Roch22/Dolphin-Floater/releases/v4/tube v3 vs v4.png

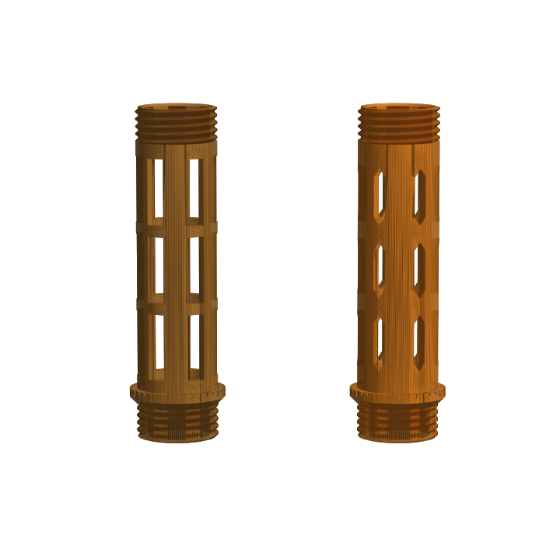
releases/v4/tube v3 vs v4.png
