Roch22/Dolphin-Floater/releases/v1 test pack/Dolphin Floater v1 TEST PACK.3mf

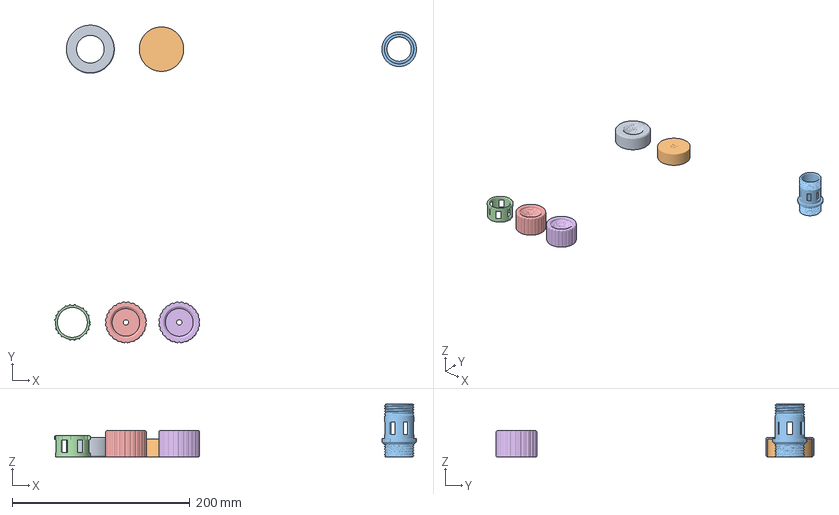
[picture p2: CAD file, 2026-10-24]
releases/v1 test pack/Dolphin Floater v1 TEST PACK.3mf
407.0 x 357.2 x 59.5 mm
socket_test
leak_test_puck
tube_test
sleeve_test
cap_0.25
cap_0.35
