Roch22/Dolphin-Floater/releases/v1 test pack/STL/sleeve_test.stl

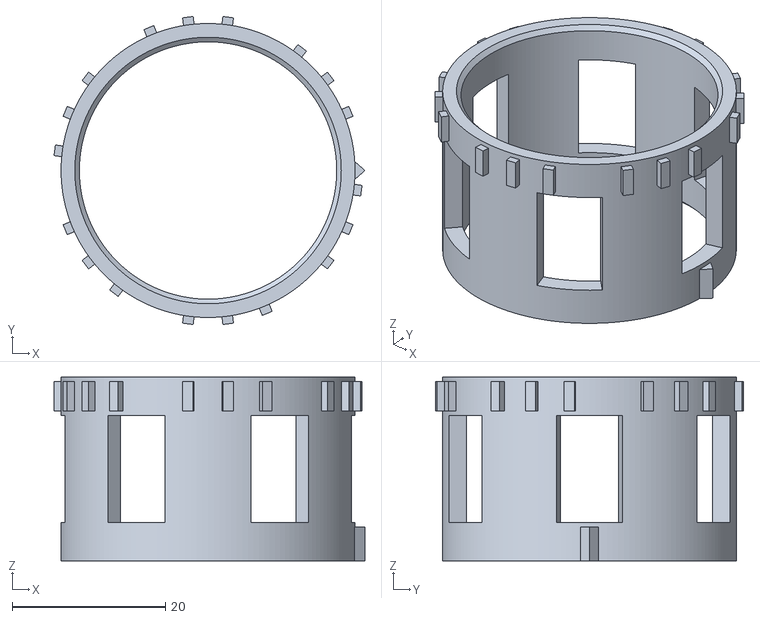
[picture p3: CAD file, 2026-10-24]
releases/v1 test pack/STL/sleeve_test.stl
40.6 x 40.2 x 24.0
