Roch22/Dolphin-Floater/releases/v4/Tube v4 test.3mf

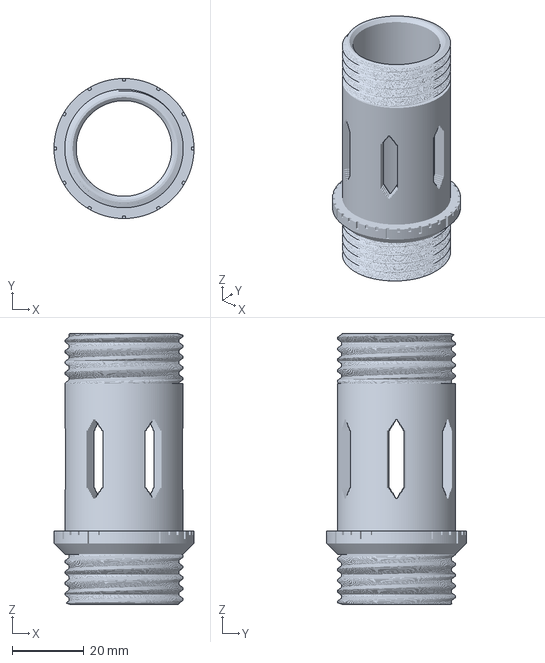
[picture p4: CAD file, 2026-10-29]
releases/v4/Tube v4 test.3mf
39.0 x 39.0 x 75.5 mm
