Roch22/Dolphin-Floater/releases/v1 test pack/STL/socket_test.stl

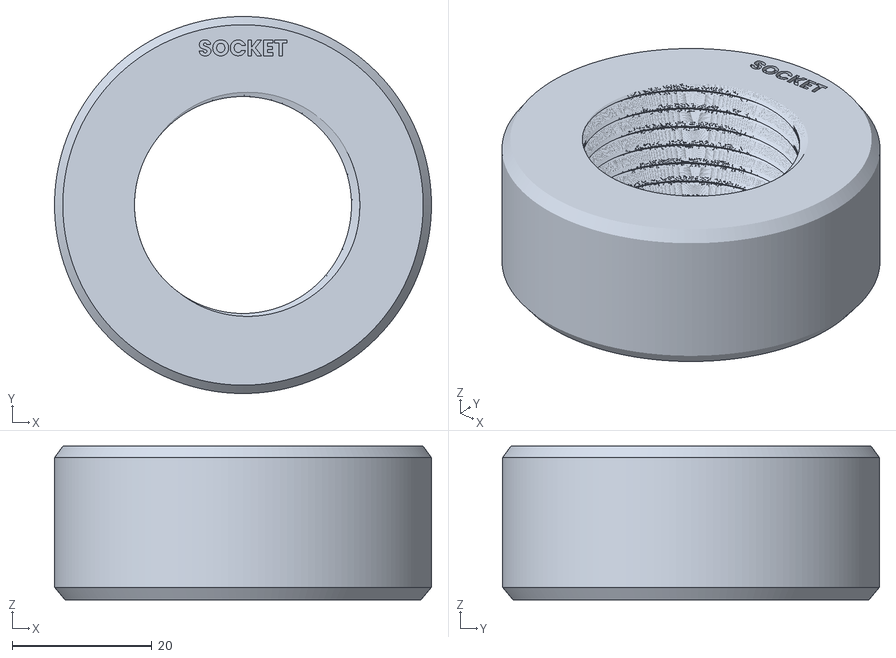
[picture p5: CAD file, 2026-10-24]
releases/v1 test pack/STL/socket_test.stl
54.0 x 54.0 x 22.0
