Roch22/Dolphin-Floater/releases/v4/Dolphin Floater v4.3mf

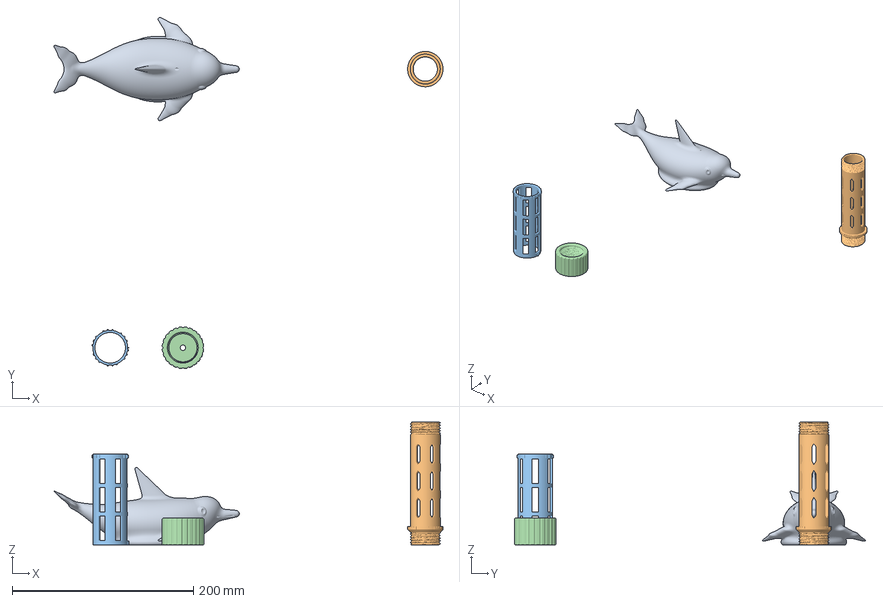
[picture p6: CAD file, 2026-10-29]
releases/v4/Dolphin Floater v4.3mf
428.8 x 387.1 x 135.5 mm
dolphin_float
tube_v4
sleeve
cap_washer_pause
