Roch22/Dolphin-Floater/releases/v1 test pack/STL/leak_test_puck.stl

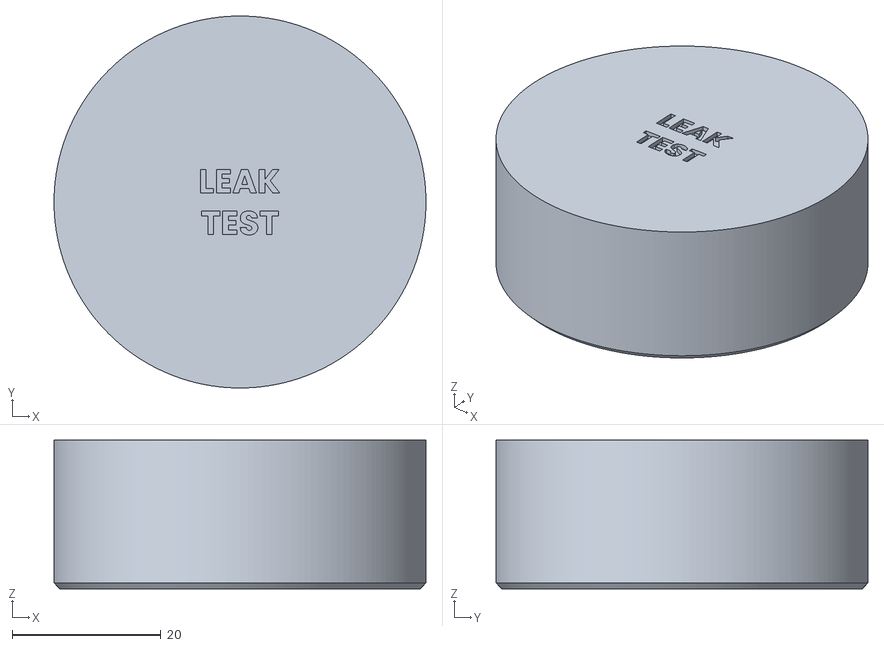
[picture p7: CAD file, 2026-10-24]
releases/v1 test pack/STL/leak_test_puck.stl
50.0 x 50.0 x 20.0
