Roch22/Dolphin-Floater/releases/v1 test pack/STL/tube_test.stl

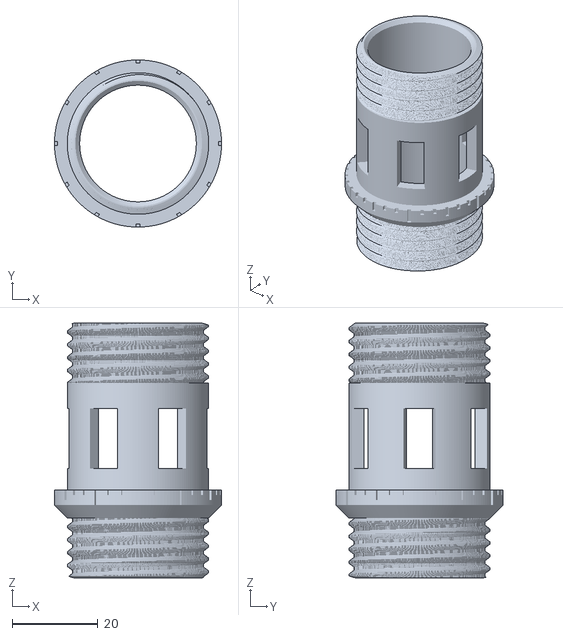
[picture p8: CAD file, 2026-10-24]
releases/v1 test pack/STL/tube_test.stl
39.0 x 39.0 x 59.5
