Roch22/Dolphin-Floater/releases/v1 test pack/STL/cap_0.35.stl

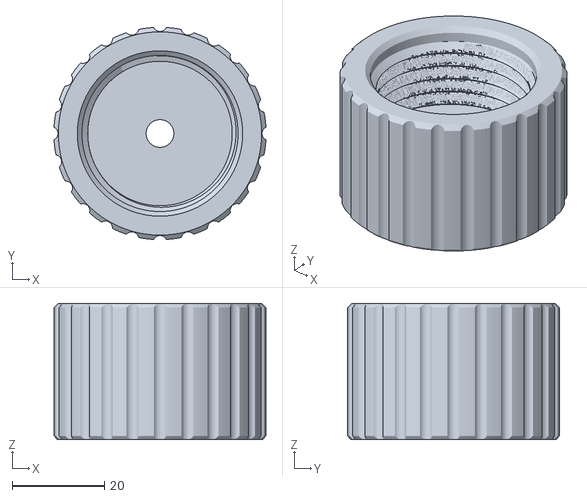
[picture p9: CAD file, 2026-10-24]
releases/v1 test pack/STL/cap_0.35.stl
45.9 x 45.9 x 29.5
