Roch22/Dolphin-Floater/releases/v3/Dolphin Floater v3.3mf

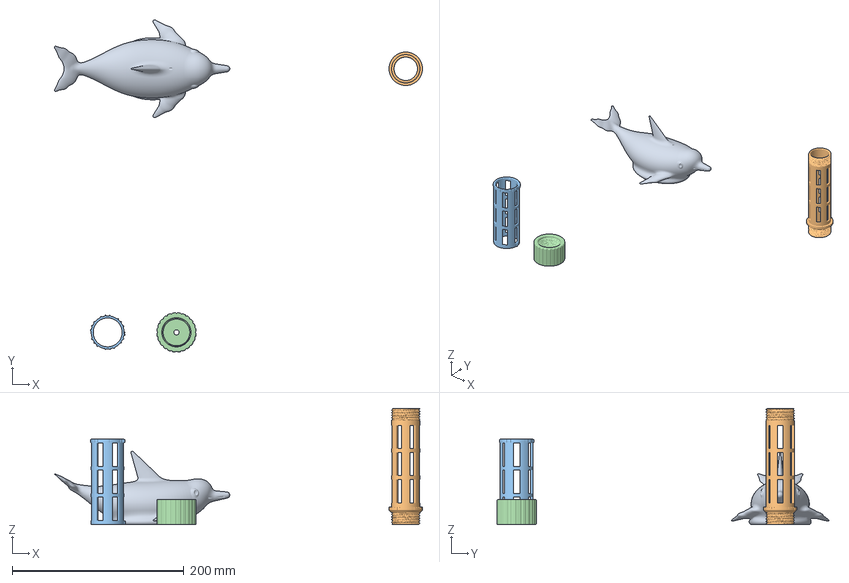
[picture p10: CAD file, 2026-10-24, an earlier design]
releases/v3/Dolphin Floater v3.3mf
428.8 x 387.1 x 135.5 mm
dolphin_float
tube
sleeve
cap_washer_pause
