Roch22/Dolphin-Floater/releases/v3/STL/dolphin_float.stl

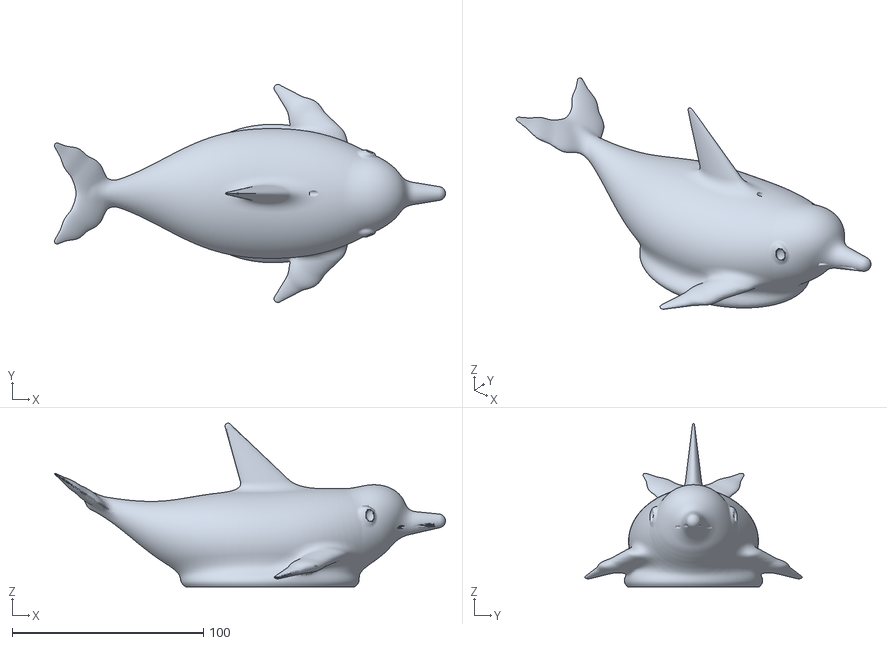
[picture p11: CAD file, 2026-10-24, an earlier design]
releases/v3/STL/dolphin_float.stl
204.3 x 113.9 x 85.6
