Roch22/Dolphin-Floater/releases/v3/STL/tube.stl

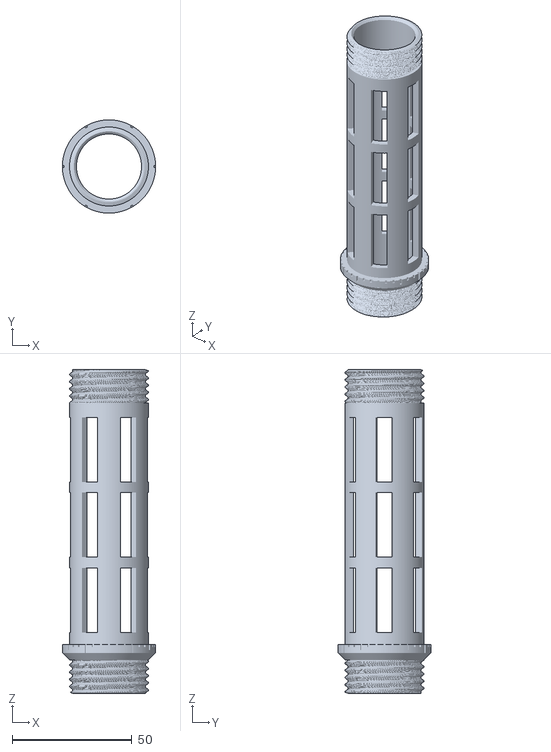
[picture p12: CAD file, 2026-10-24, an earlier design]
releases/v3/STL/tube.stl
39.0 x 39.0 x 135.5
