Roch22/Dolphin-Floater/releases/v3/STL/sleeve.stl

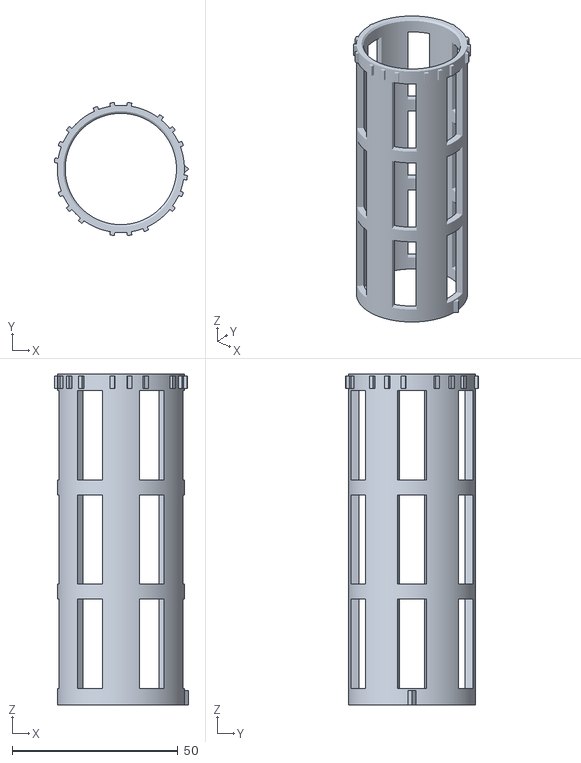
[picture p13: CAD file, 2026-10-24, an earlier design]
releases/v3/STL/sleeve.stl
40.6 x 40.2 x 100.0
