Roch22/Dolphin-Floater/(list of files, cad)

Other CAD files:
releases/v1 test pack/STL/cap_0.25.stl
releases/v3/STL/cap_washer_pause.stl
