Roch22/Dolphin-Floater/releases/v1 test pack/preview.png

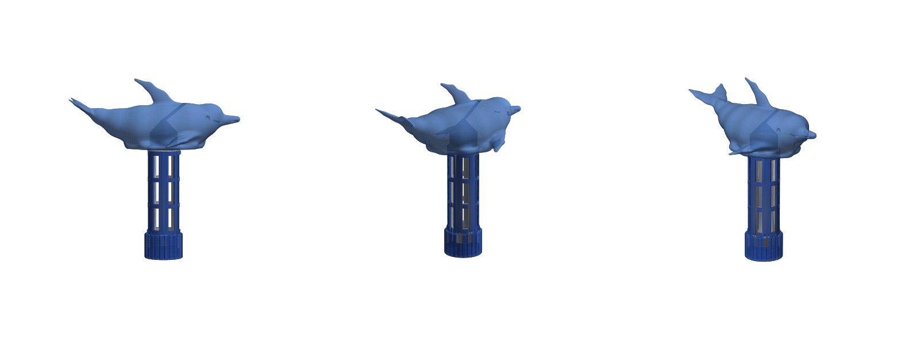
releases/v1 test pack/preview.png
