Roch22/Dolphin-Floater/(commit log)

2026-10-24 Dolphin Floater: v3 floater, v1 test pack, build scripts
    Claude-Session: https://claude.ai/code/session_01Q8MB72wM85t5kkzGquimyD
    [Dolphin Floater v1 TEST PACK.3mf, Dolphin Floater v3.3mf]
2026-10-24 Add single-part STL exports for v3 floater and v1 test pack
    export_stl.py pulls every part out of the release 3MFs as its own binary
    STL, in print orientation. README lists what to print and the hardware.
    Claude-Session: https://claude.ai/code/session_015UBWGHPKu4aft8qFR61TBF
    [cap_0.25.stl, cap_0.35.stl, cap_washer_pause.stl, dolphin_float.stl, leak_test_puck.stl, sleeve.stl, sleeve_test.stl, socket_test.stl]
2026-10-29 v4: reinforced tube (narrower tapered slots, wider ribs and bands, thicker wall)
    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
    [Dolphin Floater v4.3mf, Tube v4 test.3mf]
